heinervdm/rpi-radio/pcb/rpi-radio.brd

## EAGLE design pcb/rpi-radio.brd (2015-02-12)

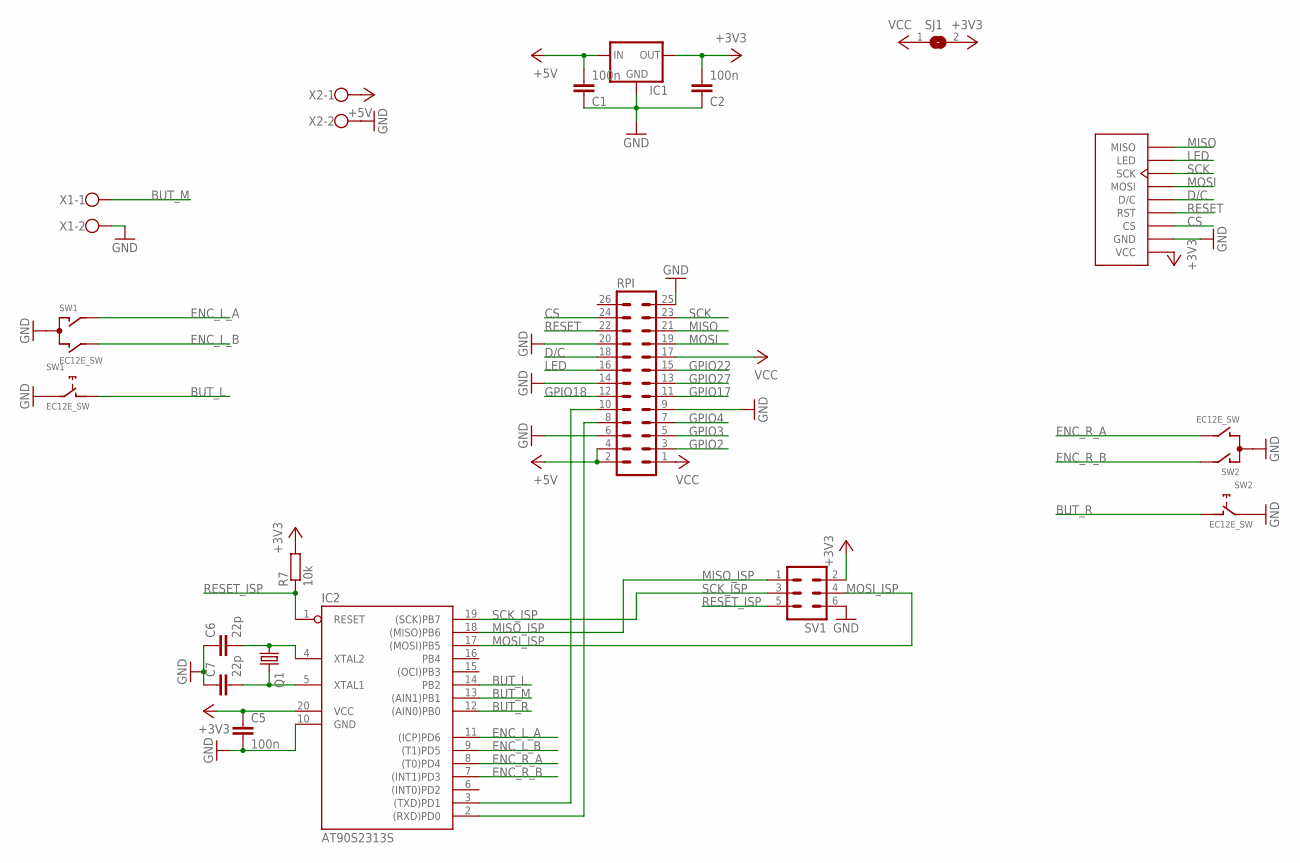
[picture p1: schematic rpi-radio.sch]

Parts:
C1, C2, C5: 100n; C0805
C6, C7: 22p; C0805
IC1: 78XXS
IC2: AT90S2313S; SO20L
Q1: CRYSTALHC49S; HC49/S
R7: 10k; M0805
RPI: ML26
SJ1: SJ
SV1: ML6
SW1, SW2: EC12E_SW; ALPS_EC12E_SW
U$4: DISPLAY
X1, X2: W237-102

Connections:
+3V3: C2.2, C5.1, IC1.OUT, IC2.20 (VCC), R7.2, SJ1.2, SV1.2, U$4.P$1 (VCC)
+5V: C1.2, IC1.IN, RPI.2, RPI.4, X2.1
BUT_L: IC2.14 (PB2), SW1.D (1)
BUT_M: IC2.13 ((AIN1)PB1), X1.1
BUT_R: IC2.12 ((AIN0)PB0), SW2.D (1)
CS: RPI.24, U$4.P$3 (CS)
D/C: RPI.18, U$4.P$5 (D/C)
ENC_L_A: IC2.11 ((ICP)PD6), SW1.A
ENC_L_B: IC2.9 ((T1)PD5), SW1.B
ENC_R_A: IC2.8 ((T0)PD4), SW2.B
ENC_R_B: IC2.7 ((INT1)PD3), SW2.A
GND: C1.1, C2.1, C5.2, C6.1, C7.1, IC1.GND, IC2.10 (GND), RPI.6, RPI.9, RPI.14, RPI.20, RPI.25, SV1.6, SW1.C, SW1.E (2), SW2.C, SW2.E (2), U$4.P$2 (GND), X1.2, X2.2
GPIO2: RPI.3
GPIO3: RPI.5
GPIO4: RPI.7
GPIO17: RPI.11
GPIO18: RPI.12
GPIO22: RPI.15
GPIO27: RPI.13
LED: RPI.16, U$4.P$8 (LED)
MISO: RPI.21, U$4.P$9 (MISO)
MISO_ISP: IC2.18 ((MISO)PB6), SV1.1
MOSI: RPI.19, U$4.P$6 (MOSI)
MOSI_ISP: IC2.17 ((MOSI)PB5), SV1.4
unnamed: C6.2, IC2.4 (XTAL2), Q1.1
unnamed: IC2.2 ((RXD)PD0), RPI.8
unnamed: IC2.3 ((TXD)PD1), RPI.10
unnamed: C7.2, IC2.5 (XTAL1), Q1.2
RESET: RPI.22, U$4.P$4 (RST)
RESET_ISP: IC2.1 (RESET), R7.1, SV1.5
SCK: RPI.23, U$4.P$7 (SCK)
SCK_ISP: IC2.19 ((SCK)PB7), SV1.3
VCC: RPI.1, RPI.17, SJ1.1

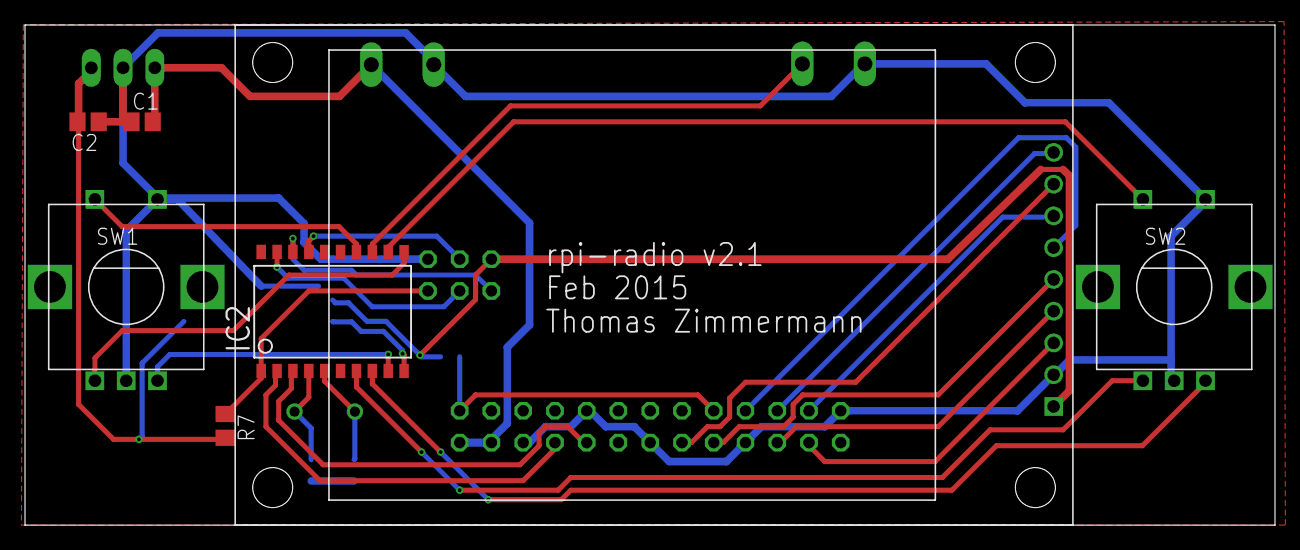
[picture p2: board rpi-radio.brd from above]

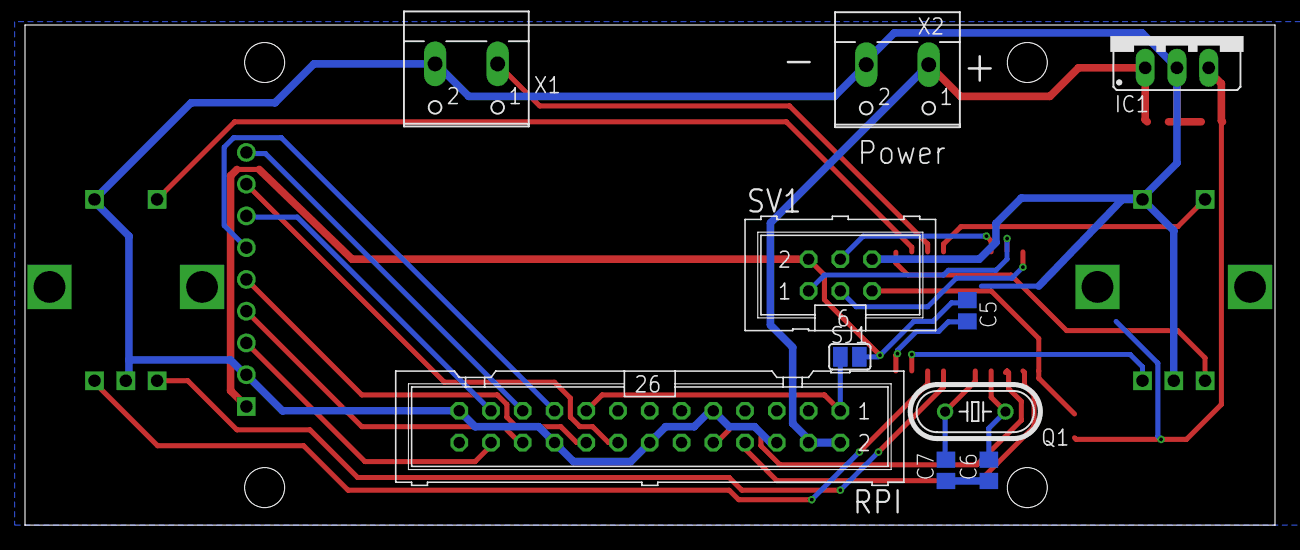
[picture p3: board rpi-radio.brd from below]

Board: 2 copper layers, 100.0 x 40.0 mm, 17 parts (10 on the bottom side), 26 nets.
