heinervdm/rpi-radio/(commit log)

2014-02-09 fix small bug in grid layout of player widget
    [PlayerWidget.cpp]
2014-02-12 Add Encoder class
2014-02-12 Encoder: Add newPos signal
2014-02-12 Add csv file with stations extracted from chip.de
2014-02-13 Fix compilation errors in Encoder and GPIO classs
    [Encoder.cpp, Encoder.h, GPIO.cpp]
2014-02-13 remove qtserialport, the buttons will be read by the rpi directly
2014-02-13 Add Button class
2014-02-13 Fix some small errors
    [Button.cpp, Button.h, GPIO.cpp, GPIO.h]
2014-02-14 Correct button borders in player.qml
2014-02-14 Encoder: make parent QObject public
2014-02-15 use uint8_t for encoder values
2014-02-15 Use more then 8bit for encoder values
2014-02-17 wip to register button click
2014-05-11 Use GPIO pins from schematic
2014-05-14 Add PCB
    [rpi-radio.brd, rpi-radio.sch]
2014-05-14 pcb: remove eagle.epf as it's not needed
2014-05-14 pcb: remove rpi-radio.pro, not needed
2014-05-18 use 1msec timer, because the encoder produces to short pulses
    [Encoder.cpp, GPIO.cpp]
2014-05-19 Add AVR firmware to read the encoders and send them via uart
2014-05-19 avr: implement encoder and button routines
2014-05-19 pcb: add attiny2313, because rpi is not able to decode the rotary encoder and use thicker traces
    [rpi-radio.brd, rpi-radio.sch]
2014-05-20 avr: correct values for repeated button press
    [main.c]
2014-05-23 Use QSerialPort to read button and encoder data from serial port
2014-07-24 Prepare CMakeLists to switch between Qt4 and Qt5
2014-07-26 Fix playing sound with phonon
    [PlayerWidget.cpp]
2014-08-06 Fix bug that name of the previous station is displayed in StationList.qml
    [PlayerWidget.cpp]
2014-11-23 Update to version v2 of the pcb. the integrated amplifier did not work properly
    [rpi-radio.brd, rpi-radio.sch]
2015-02-12 Fix wrong polarity of attiny
    [rpi-radio.brd, rpi-radio.sch]
2015-10-19 switch to my own qtmpdclient version
2015-10-20 Use PJ_RPI GPIO functions for Encoder
2016-07-12 Switch to mpd instead of Phonon
2016-07-12 Add missing MpdPlayerWidet.h, remove some unneded files
    [MpdPlayerWidget.h]
2016-07-16 Several updates
    - clean up CMakeList.txt, remove unused libs
    - Extend MenuList to highlight the currently played track in addition to the currently selected one.
    - Start Browse with mpd root instead of an additional layer
    - Add function to fetch the current playlist from mpd
    - When selecting a track or adding one to the playlist start to play this one
2016-07-17 MenuList.qml: split into List Playlist and Browse
    Split MenuList into a list and button part, so that one can use different buttons for the different lists.
2016-07-24 insert playlist clear button
